HamiltonGerlach/MultiStompController/doc/settings.png

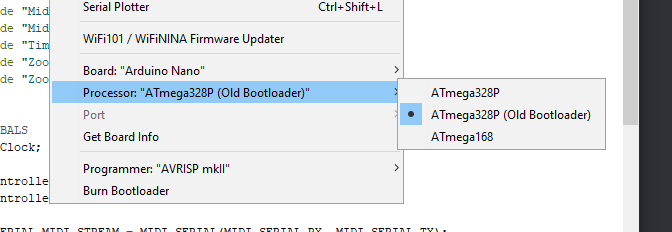
doc/settings.png
