HamiltonGerlach/MultiStompController/(threads)

Thread 1 (2020-09-07):

Add support for SRAM extensions

HamiltonGerlach, 2020-09-07:
Possible Arduino SRAM extensions via Serial SPI/I²C:

[https://www.hobbytronics.co.uk/electronic-components/misc-ic/23lc1024](https://www.hobbytronics.co.uk/electronic-components/misc-ic/23lc1024)
[https://www.hobbytronics.co.uk/electronic-components/misc-ic/eeprom-24lc256](https://www.hobbytronics.co.uk/electronic-components/misc-ic/eeprom-24lc256)

HamiltonGerlach, 2020-09-09:
Implemented in #93774b76480e7eaca1666104072e0473bd2ee3b2.

Closed 2020-09-09.
