HamiltonGerlach/MultiStompController/ParamMap.h

#ifndef PARAMMAP_H
#define PARAMMAP_H

#define PARAM_LENGTH_P0 12
#define PARAM_LENGTH_P1 11
#define PARAM_LENGTH_P2 11
#define PARAM_LENGTH_P3 8
#define PARAM_LENGTH_P4 8
#define PARAM_LENGTH_P5 8
#define PARAM_LENGTH_P6 8
#define PARAM_LENGTH_P7 9
#define PARAM_LENGTH_P8 8
#define PARAM_LENGTH_MAX 12

#define PARAM_NUM 9

// Patch parameter map:
//  [Effect]        ... 0 - 5
//  [Param]         ... 0 - 8
//  [Bit of value]  ... 0 - 11
//  [Offset/Index]  ... 0 (Offset), 1 (Bit index)

// Access via pgm_read_byte_near(&ParamMap[i][j][k][l])

byte ParamLength[PARAM_NUM] = { PARAM_LENGTH_P0,
                                PARAM_LENGTH_P1,
                                PARAM_LENGTH_P2,
                                PARAM_LENGTH_P3,                                
                                PARAM_LENGTH_P4,
                                PARAM_LENGTH_P5,
                                PARAM_LENGTH_P6,
                                PARAM_LENGTH_P7,
                                PARAM_LENGTH_P8 };

const PROGMEM byte ParamMap[ZOOM_EFF_NO][PARAM_NUM][PARAM_LENGTH_MAX][2] =
{
    { // EFFECT 0
        {   // EFFECT 0 PARAMETER 0
            { 9  , 5 },
            { 9  , 6 },
            { 5  , 3 },
            { 10 , 0 },
            { 10 , 1 },
            { 10 , 2 },
            { 10 , 3 },
            { 10 , 4 },
            { 10 , 5 },
            { 10 , 6 },
            { 5  , 2 },
            { 11 , 0 }
        }, 
        
        {   // EFFECT 0 PARAMETER 1
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
// b4      123     0
// b5      123     1
// b6      123     2
// b7      123     3
// b8      123     4
// 
// Param 8
// 
// b0      127     0
// b1      127     1
// b2      127     2
// b3      127     3
// b4      127     4
// b5      127     5
// b6      127     6
// b7      125     5
