HamiltonGerlach/MultiStompController/MemMap.h

#ifndef MEMMAP_H
#define MEMMAP_H

#include "Arduino.h"

const PROGMEM unsigned int MEM_ADDR_PATCH[ZOOM_PATCH_NO] =
{
    100,
    300,
    500,
    700,
    900,
    1100,
    1300,
    1500,
    1700,
    1900,
    2100,
    2300,
    2500,
    2700,
    2900,
    3100,
    3300,
    3500,
    3700,
    3900,
    4100,
    4300,
    4500,
    4700,
    4900,
    5100,
    5300,
    5500,
    5700,
    5900,
    6100,
    6300,
    6500,
    6700,
    6900,
    7100,
    7300,
    7500,
    7700,
    7900,
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
  };
  
  #endif
