HamiltonGerlach/MultiStompController/(commit log)

2020-09-01 Structural redesign. MidiBuffer (static), ZoomIf (static), etc.
    [Array.h, Controller.cpp, Controller.h, Log.ino, MidiBuffer.cpp, MidiBuffer.h, MidiOutIf.cpp, MidiOutIf.h]
2020-09-07 Current effects now update via ZoomIf::HandleInput
2020-09-11 GetParam/SetParam
    Methods for reading/writing parameter values from current buffer patch
2021-03-14 MIDI CC ramping mode added, non-static timer class
2021-03-17 Formatting and revert debug mode.
    [Array.h, FlashMem.h, Log.cpp, Log.h, MemMap.h, MidiBuffer.h, MidiController.cpp, MidiController.h]
2022-04-30 Added IRIDIUM_PN_FORCE_PATCH to force patch setting
    Updated documentation.
    [ParamMap.txt]
